fletcheaston/SmartFarm/DAQ/Diagrams/Board Overview.png

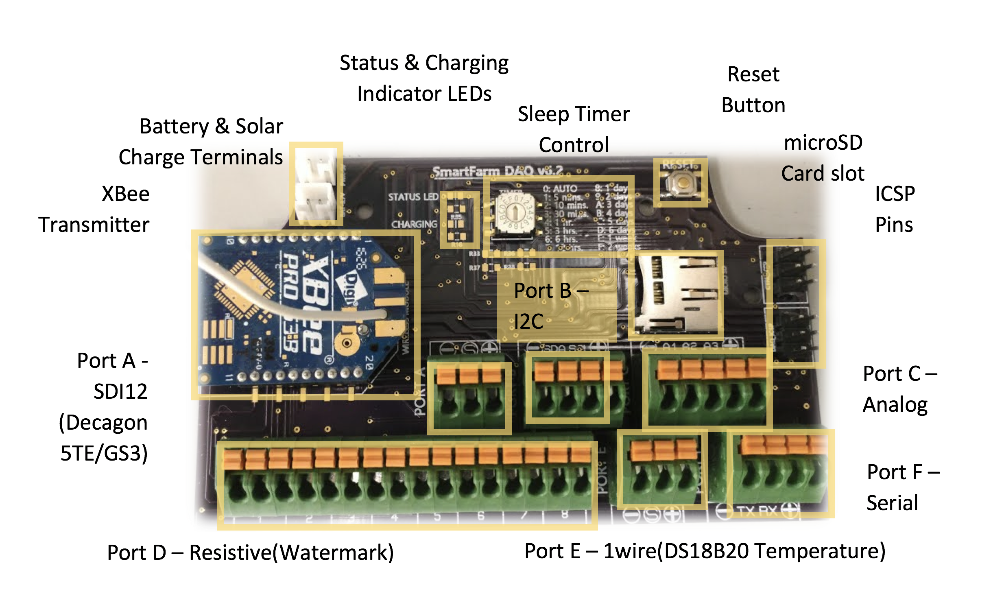
DAQ/Diagrams/Board Overview.png
