fletcheaston/SmartFarm/BaseStation/Webserver/Images/board_6_2.png

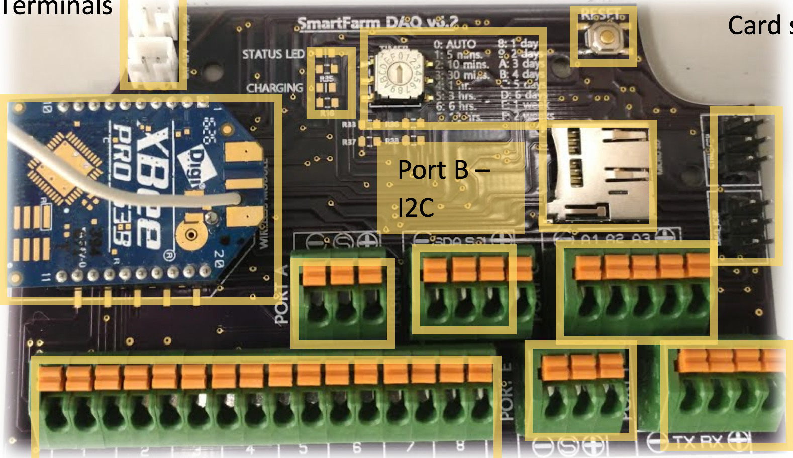
BaseStation/Webserver/Images/board_6_2.png
