fletcheaston/SmartFarm/README.md

This repository hosts the latest and greatest SmartFarm software.
