fletcheaston/SmartFarm/DAQ/README.md

The latest DAQ board version is 6.2. This board version is not likely to change anytime soon.
