fletcheaston/SmartFarm/BaseStation/Webserver/Images/board_6_2.jpg

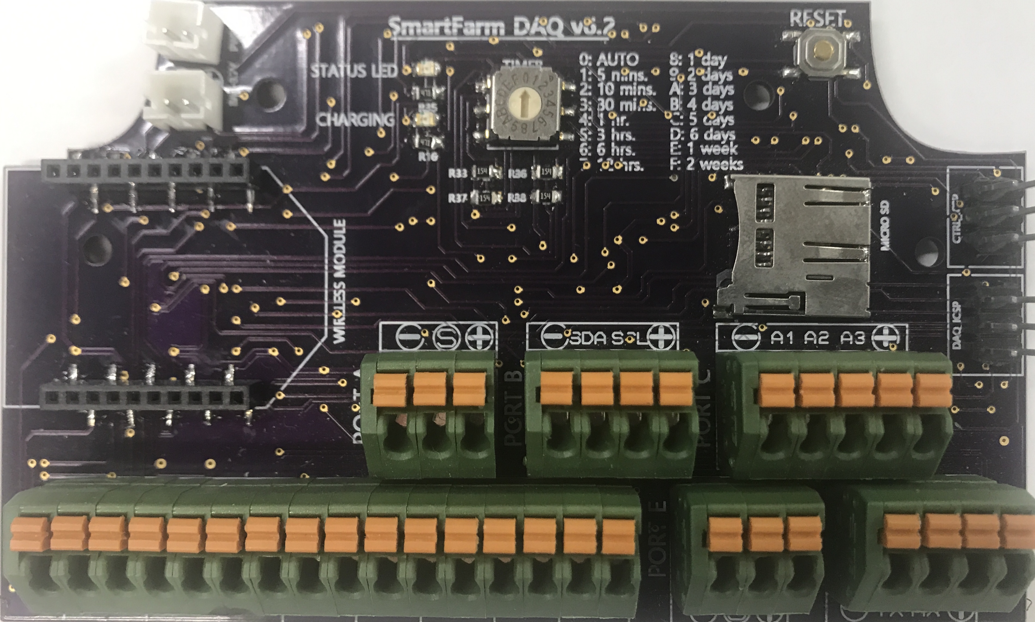
BaseStation/Webserver/Images/board_6_2.jpg
