fletcheaston/SmartFarm/BaseStation/Webserver/Images/board_6_2_flat.png

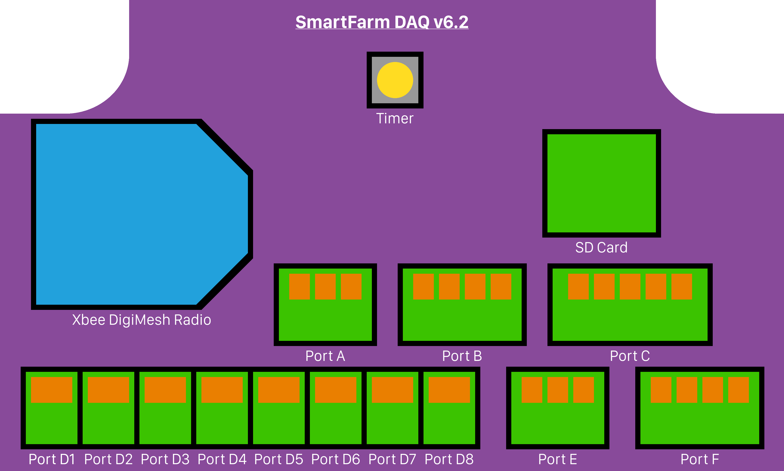
BaseStation/Webserver/Images/board_6_2_flat.png
