fletcheaston/SmartFarm/DAQ/Diagrams/v6_2 Sensor Port.png

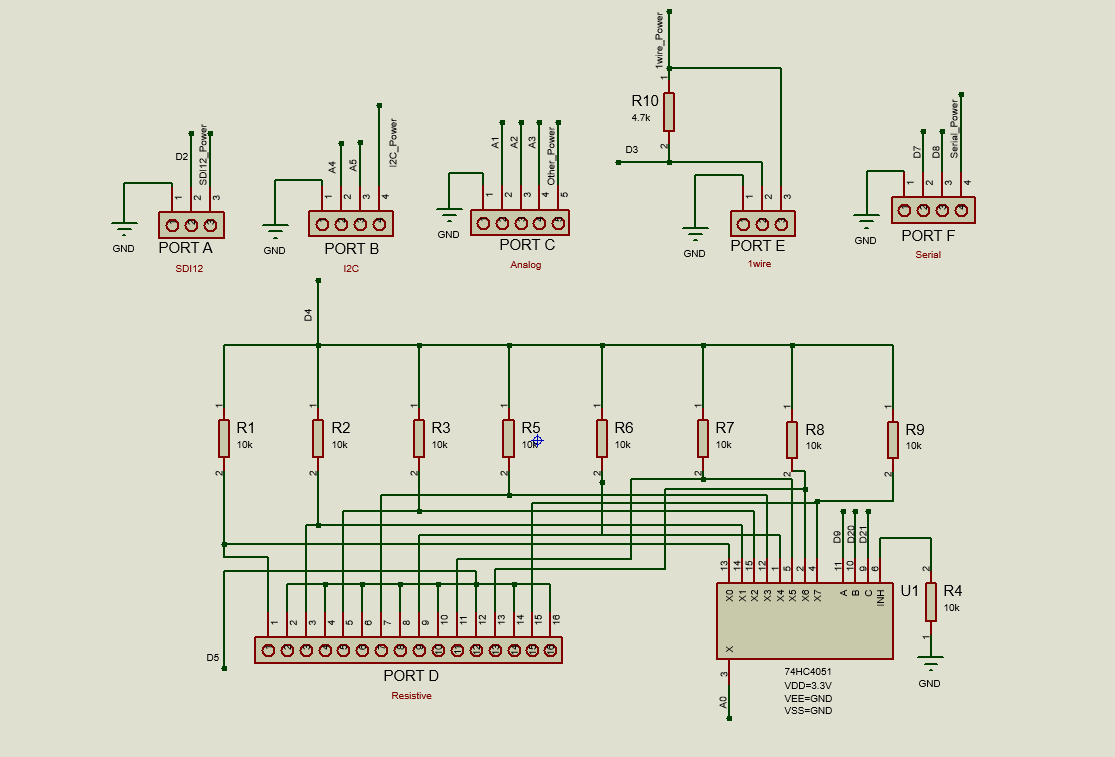
DAQ/Diagrams/v6_2 Sensor Port.png
