fletcheaston/SmartFarm/DAQ/Diagrams/v6_2ChargeController.png

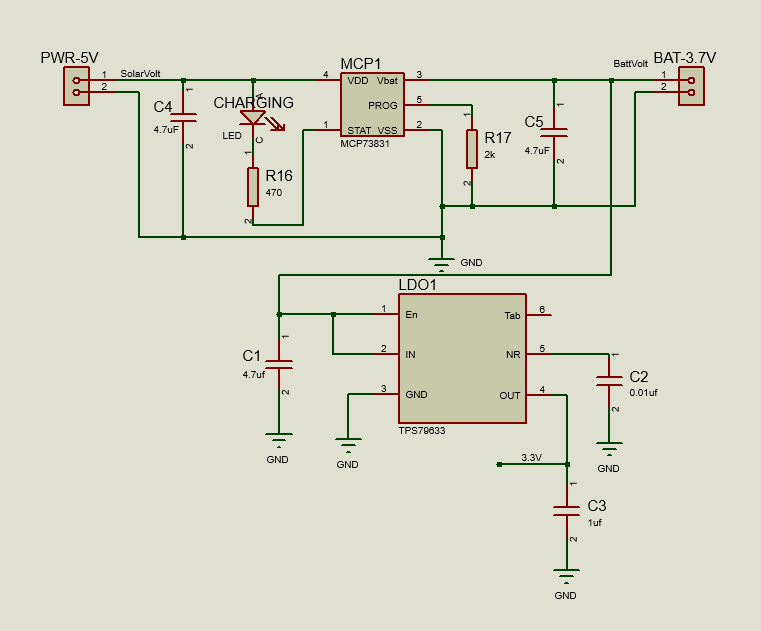
DAQ/Diagrams/v6_2ChargeController.png
