fletcheaston/SmartFarm/DAQ/Diagrams/v6_2DAQ.png

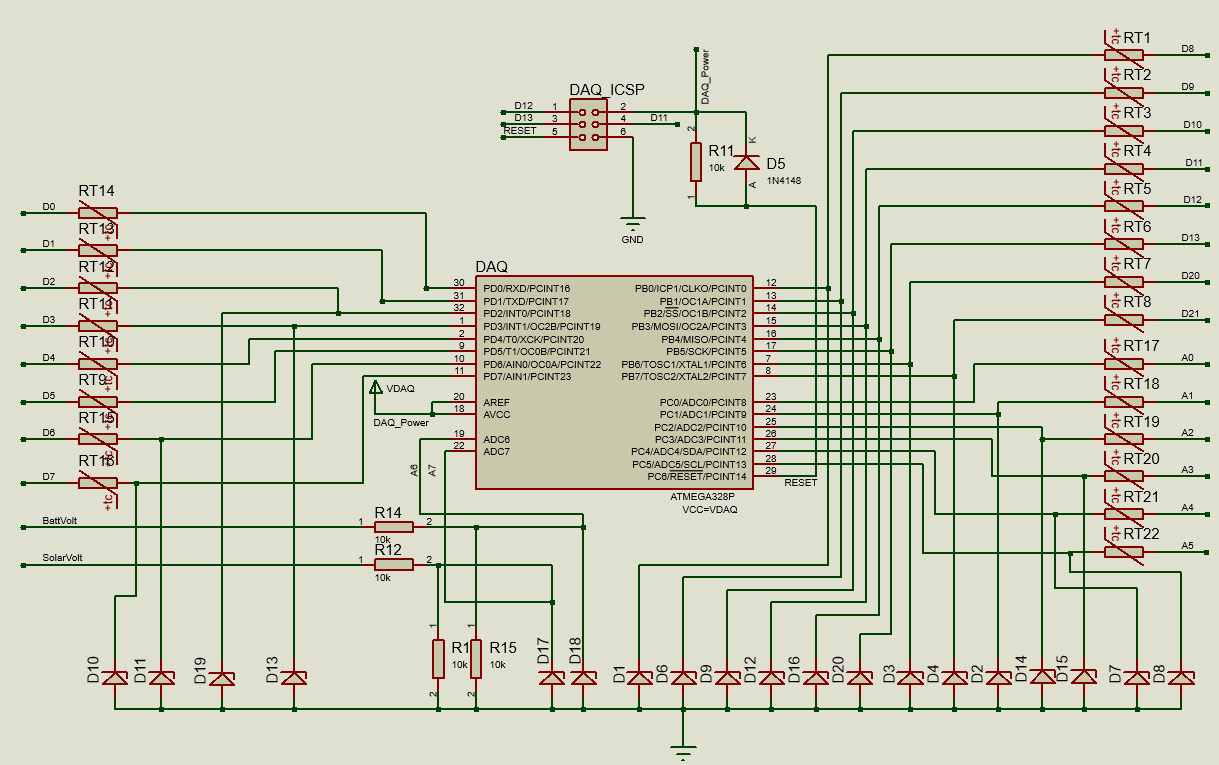
DAQ/Diagrams/v6_2DAQ.png
