fletcheaston/SmartFarm/DAQ/Diagrams/v6_2MCU.png

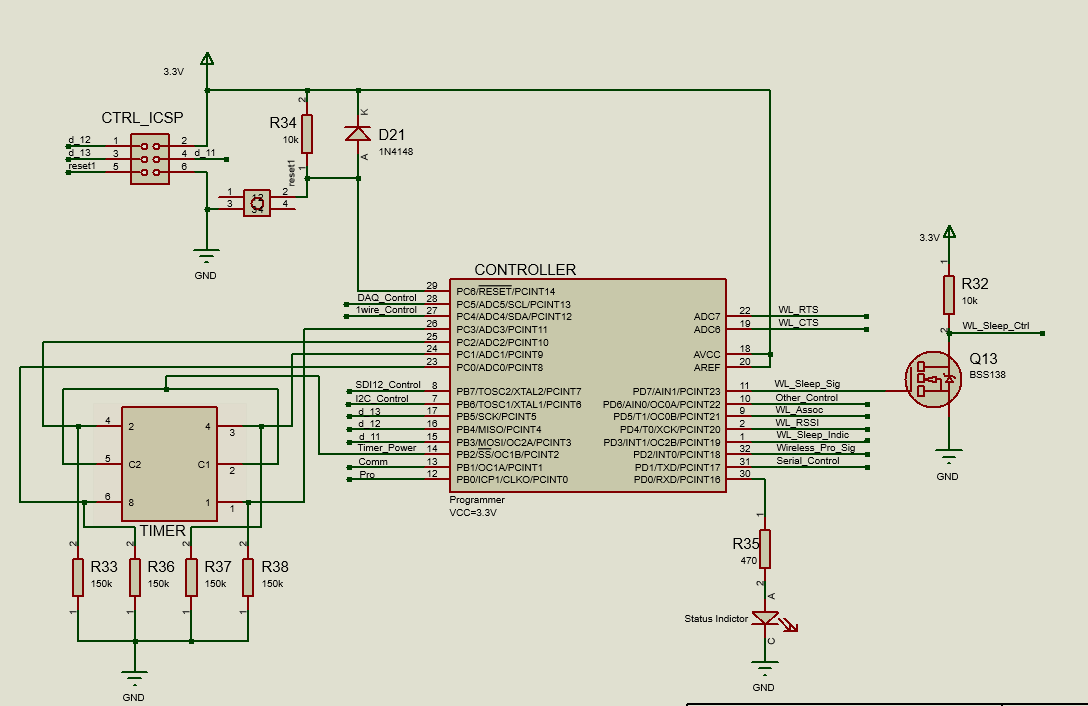
DAQ/Diagrams/v6_2MCU.png
