fletcheaston/SmartFarm/DAQ/Diagrams/v6_2Overview.png

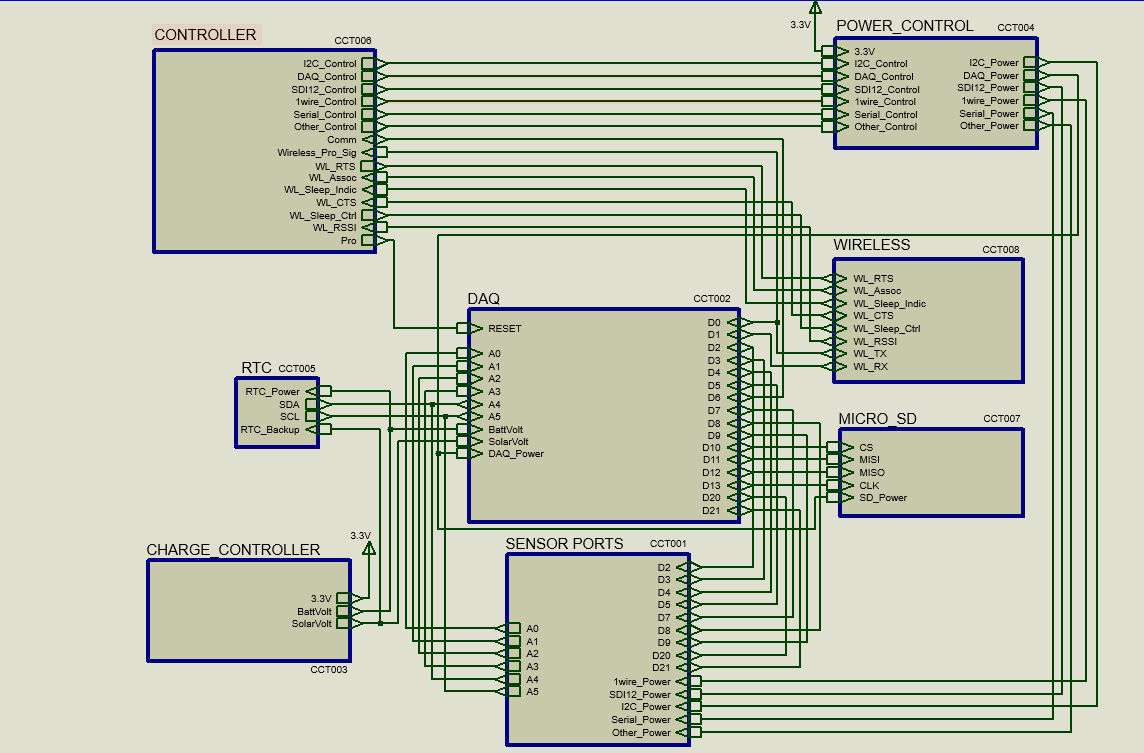
DAQ/Diagrams/v6_2Overview.png
