fletcheaston/SmartFarm/DAQ/Diagrams/v6_2RTC.png

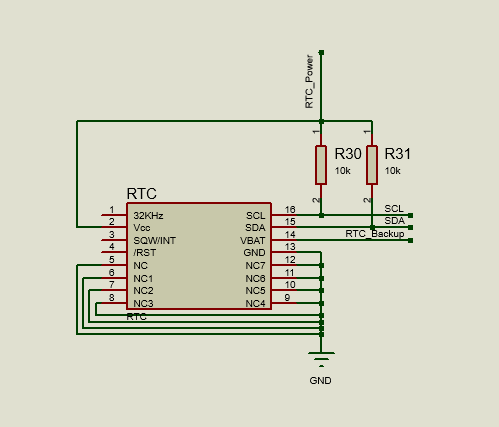
DAQ/Diagrams/v6_2RTC.png
