fletcheaston/SmartFarm/DAQ/Diagrams/v6_2SD.png

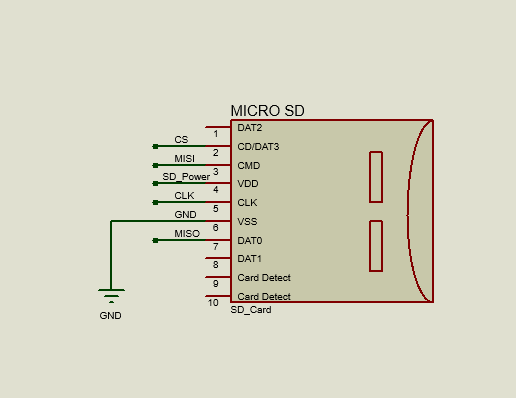
DAQ/Diagrams/v6_2SD.png
