fletcheaston/SmartFarm/DAQ/Diagrams/v6_2Wireless.png

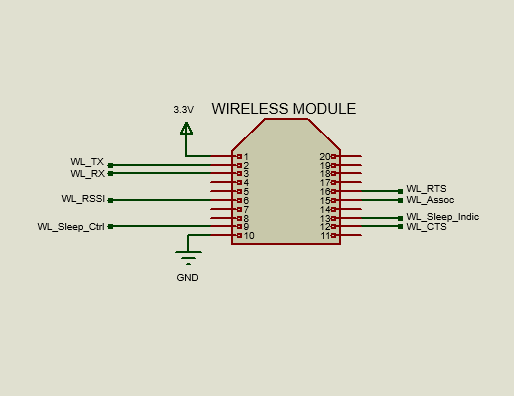
DAQ/Diagrams/v6_2Wireless.png
