fletcheaston/SmartFarm/FresnoTrips/Screen Shot 2019-03-15 at 4.10.36 PM.png

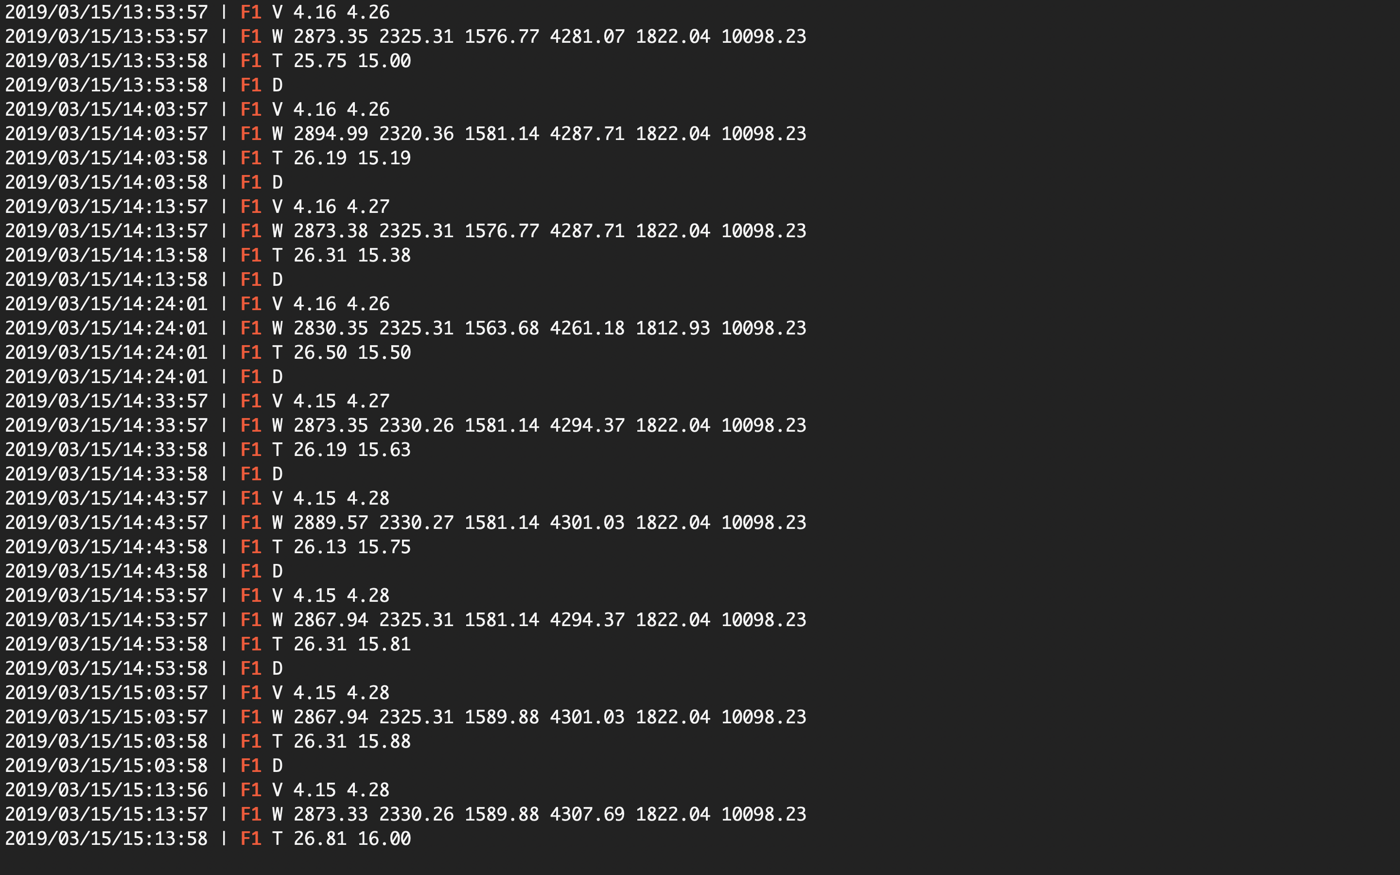
FresnoTrips/Screen Shot 2019-03-15 at 4.10.36 PM.png
