fletcheaston/SmartFarm/FresnoTrips/Screen Shot 2019-03-15 at 4.59.24 PM.png

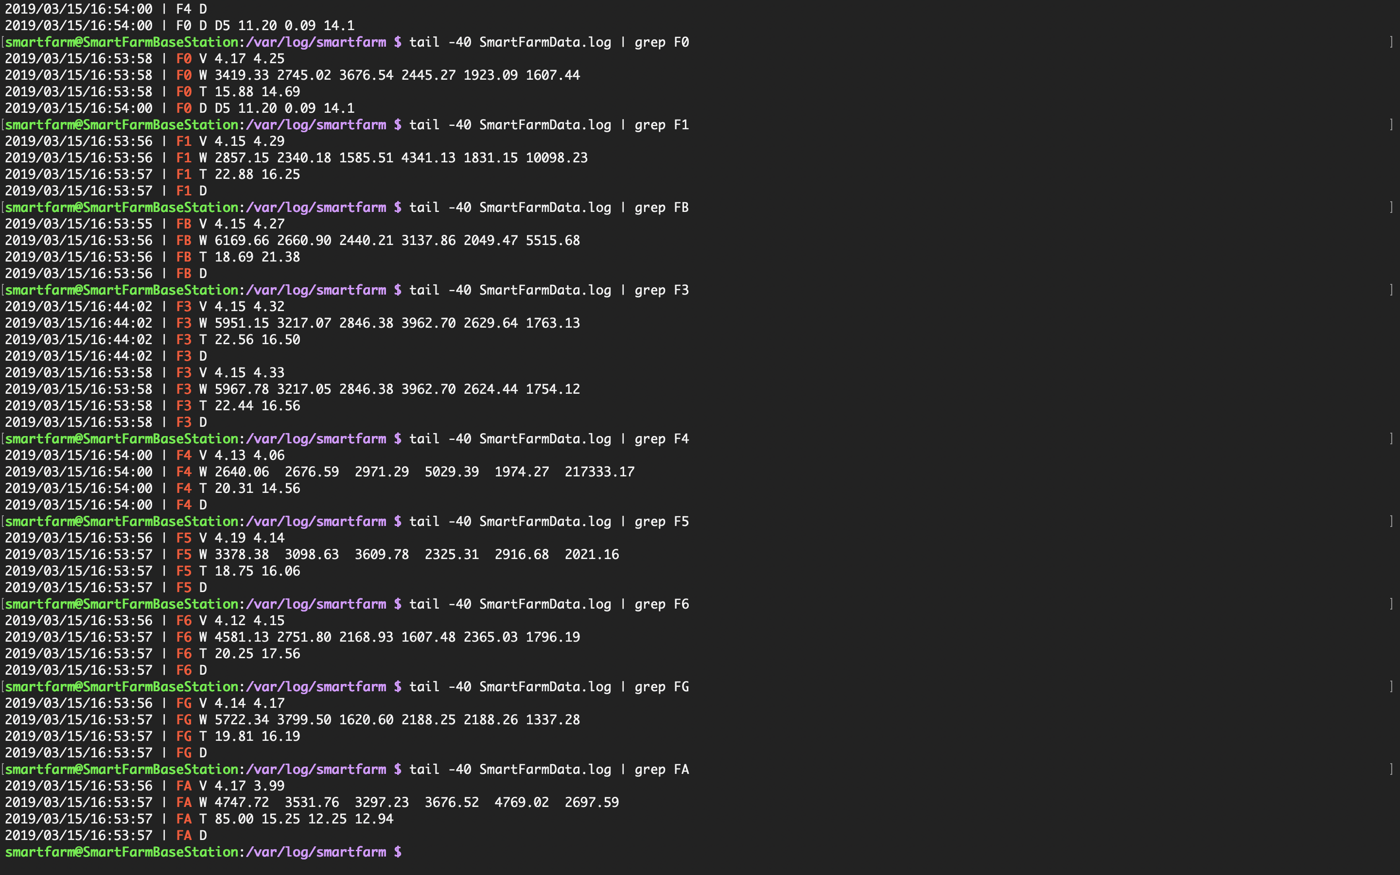
FresnoTrips/Screen Shot 2019-03-15 at 4.59.24 PM.png
