fletcheaston/SmartFarm/Screen Shot 2019-01-18 at 4.02.38 PM.png

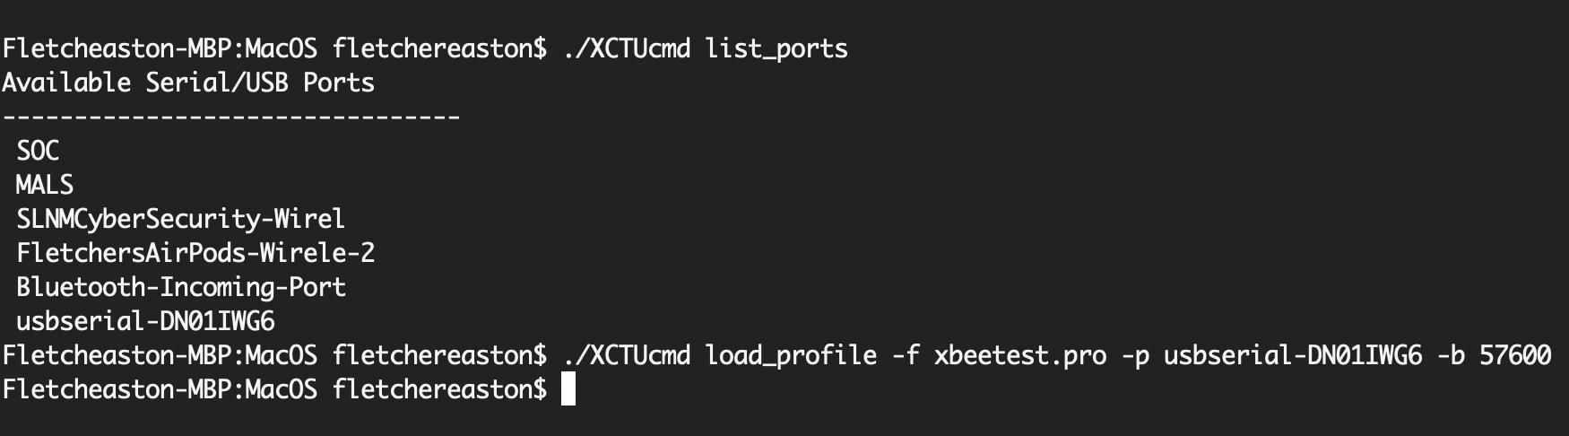
Screen Shot 2019-01-18 at 4.02.38 PM.png
