fletcheaston/SmartFarm/Board Testing and Data Checks.xlsx

Sheet: Watermark Analysis
Count | west 1 | west 2 | west 3 | east 1 | east 2 | east 3 | west 1 | west 2 | west 3 | east 1 | east 2 | east 3 | west 1 | west 2 | west 3 | east 1 | east 2 | east 3 | west 1 | west 2 | west 3 | east 1 | east 2 | east 3 | west 1 | west 2 | west 3 | east 1 | east 2 | east 3 | west 1 | west 2 | west 3 | east 1 | east 2 | east 3 | west 1 | west 2 | west 3 | east 1 | east 2 | east 3 | west 1 | west 2 | west 3 | east 1 | east 2 | east 3 | west 1 | west 2 | west 3 | east 1 | east 2 | east 3
0 | 5918.06 | 6816.45 | 6009.42 | 21770.19 | 0 | 3496.06 | 3460.54 | 9585.21 | 15280.1 | 7760.45 | 5445.4 | 6178.19 | 11582.34 | 16548.48 | 26021.42 | 15920.65 | 6491.14 | 10098.23 | 0 | 35199.02 | 46004.03 | 14670.45 | 9375 | 36081.09 | 16686.99 | 10190.81 | 10501 | 15725.1 | 11781.43 | 14454.22 | 24656.24 | 5193.08 | 7477.23 | 7417.72 | 9014.91 | 25074.38 | 10514.72 | 3899.47 | 22510.67 | 3454.63 | 18575.42 | 5437.66 | 9736.35 | 7668.39 | 3268.5 | 2040.03 | 2501.02 | 1835.71 | 4769.02 | 4656.18 | 3454.63 | 11689.07 | 10111.42 | 6679.36
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
