fletcheaston/SmartFarm/(commit log)

2018-06-24 More commits to this large repo. Attempted to fix some bugs in the DAQ library, concerning the Watermark sensors.
2018-06-24 Library changes for the Watermark sensors.
2018-06-24 Updated standard measurement program to work with current working library.
2018-06-25 Reverting master to an old branch...
    [StandardMeasurement_v6_2.ino]
2018-06-25 Temperature library updates, standard measurement program changed to reflect these updates.
2018-06-25 This update fixes the temperature readings. Watermarks are also now displayed properly.
    [standard_measurement_v6_2.ino]
2018-06-26 Much better printing format now, and the read sensor functions make a bit more sense at a glance. Still having some bugs with printing out the watermark data with the timestamp and board id. Will inv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
    [standard_measurement_v6_2.ino]
2018-06-26 Still unable to solve the crazy serial printing issue. An issue for tomorrow, perhaps.
    [standard_measurement_v6_2.ino]
2018-06-26 All but decagon prints properly.
2018-06-27 A bit of cleanup, as well as reliable sensor readings.
2018-06-27 Eliminated nearly all, if not all, of the decagon sensor functions from the library and program. Decagons will no longer be used.
    [standard_measurement_v6_2.ino]
2018-07-01 A huge commit! The library files were updated to include the decagon functions, which are still wanted by the SB team. The DAQ program now gives voltage, watermark, and temperature data in a single s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
    [data_logger.py, serial_reader.py, standard_measurement_v6_2.ino]
2018-07-03 Probably would've helped if I had spelled smartfarm correctly. I also removed the crazy calculation stuff, that only applies to data logging, not action logging. Silly me. All this is on the Pi now a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
    [data_logger.py]
2018-07-16 reading the 6th watermark port
    The isue is that the board reads port 7 instead of 6.
    Ports: 1-6 <---> Loop: 0-5
2018-07-16 A tiny but wonderful bug fix. Accidentally included a board work-around in a previous push, reverted the library file.
2018-07-22 Still figuring out which pins correspond to which board. Need to find a way to differentiate between boards now.
2018-08-29 Reuploaded files to fix any updates that haven't been pushed.
    [data_logger.py, serial_reader.py, standard_measurement_v6_2.ino]
2018-09-12 Added a standard measurement program for the 6.1 boards. Will test later.
2018-11-25 The client side of the text ide is mostly finished. Using localStorage, it transfers the last saved graphic ide stuff to the text ide. Should be easy to extend and add more sensors.
2018-11-27 Moved the webserver files from the 'website' dir to the 'basestation' dir. Updated the data logging scripts to be more generic (and correct).
    [data_logger.py, serial_reader.py, standard_measurement_v6_2.ino]
2018-11-28 Platformio is ready! Added all of the files and such, will move some stuff around on the Pi. More and more, I'm thinking of this as the prototype. After this all works well, I'll come back and make i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
2018-11-28 Added the smartfarm.json board file.
2019-05-16 Spreadsheet holding board testing and data analysis.
    Data analysis can be ignored. We really just want to keep track of the board testing.
    [Board Testing and Data Checks.xlsx]
